bob10042/AGX-switching-box-remote-control/diagrams/AGX_Test_Box_Circuit.pdf

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

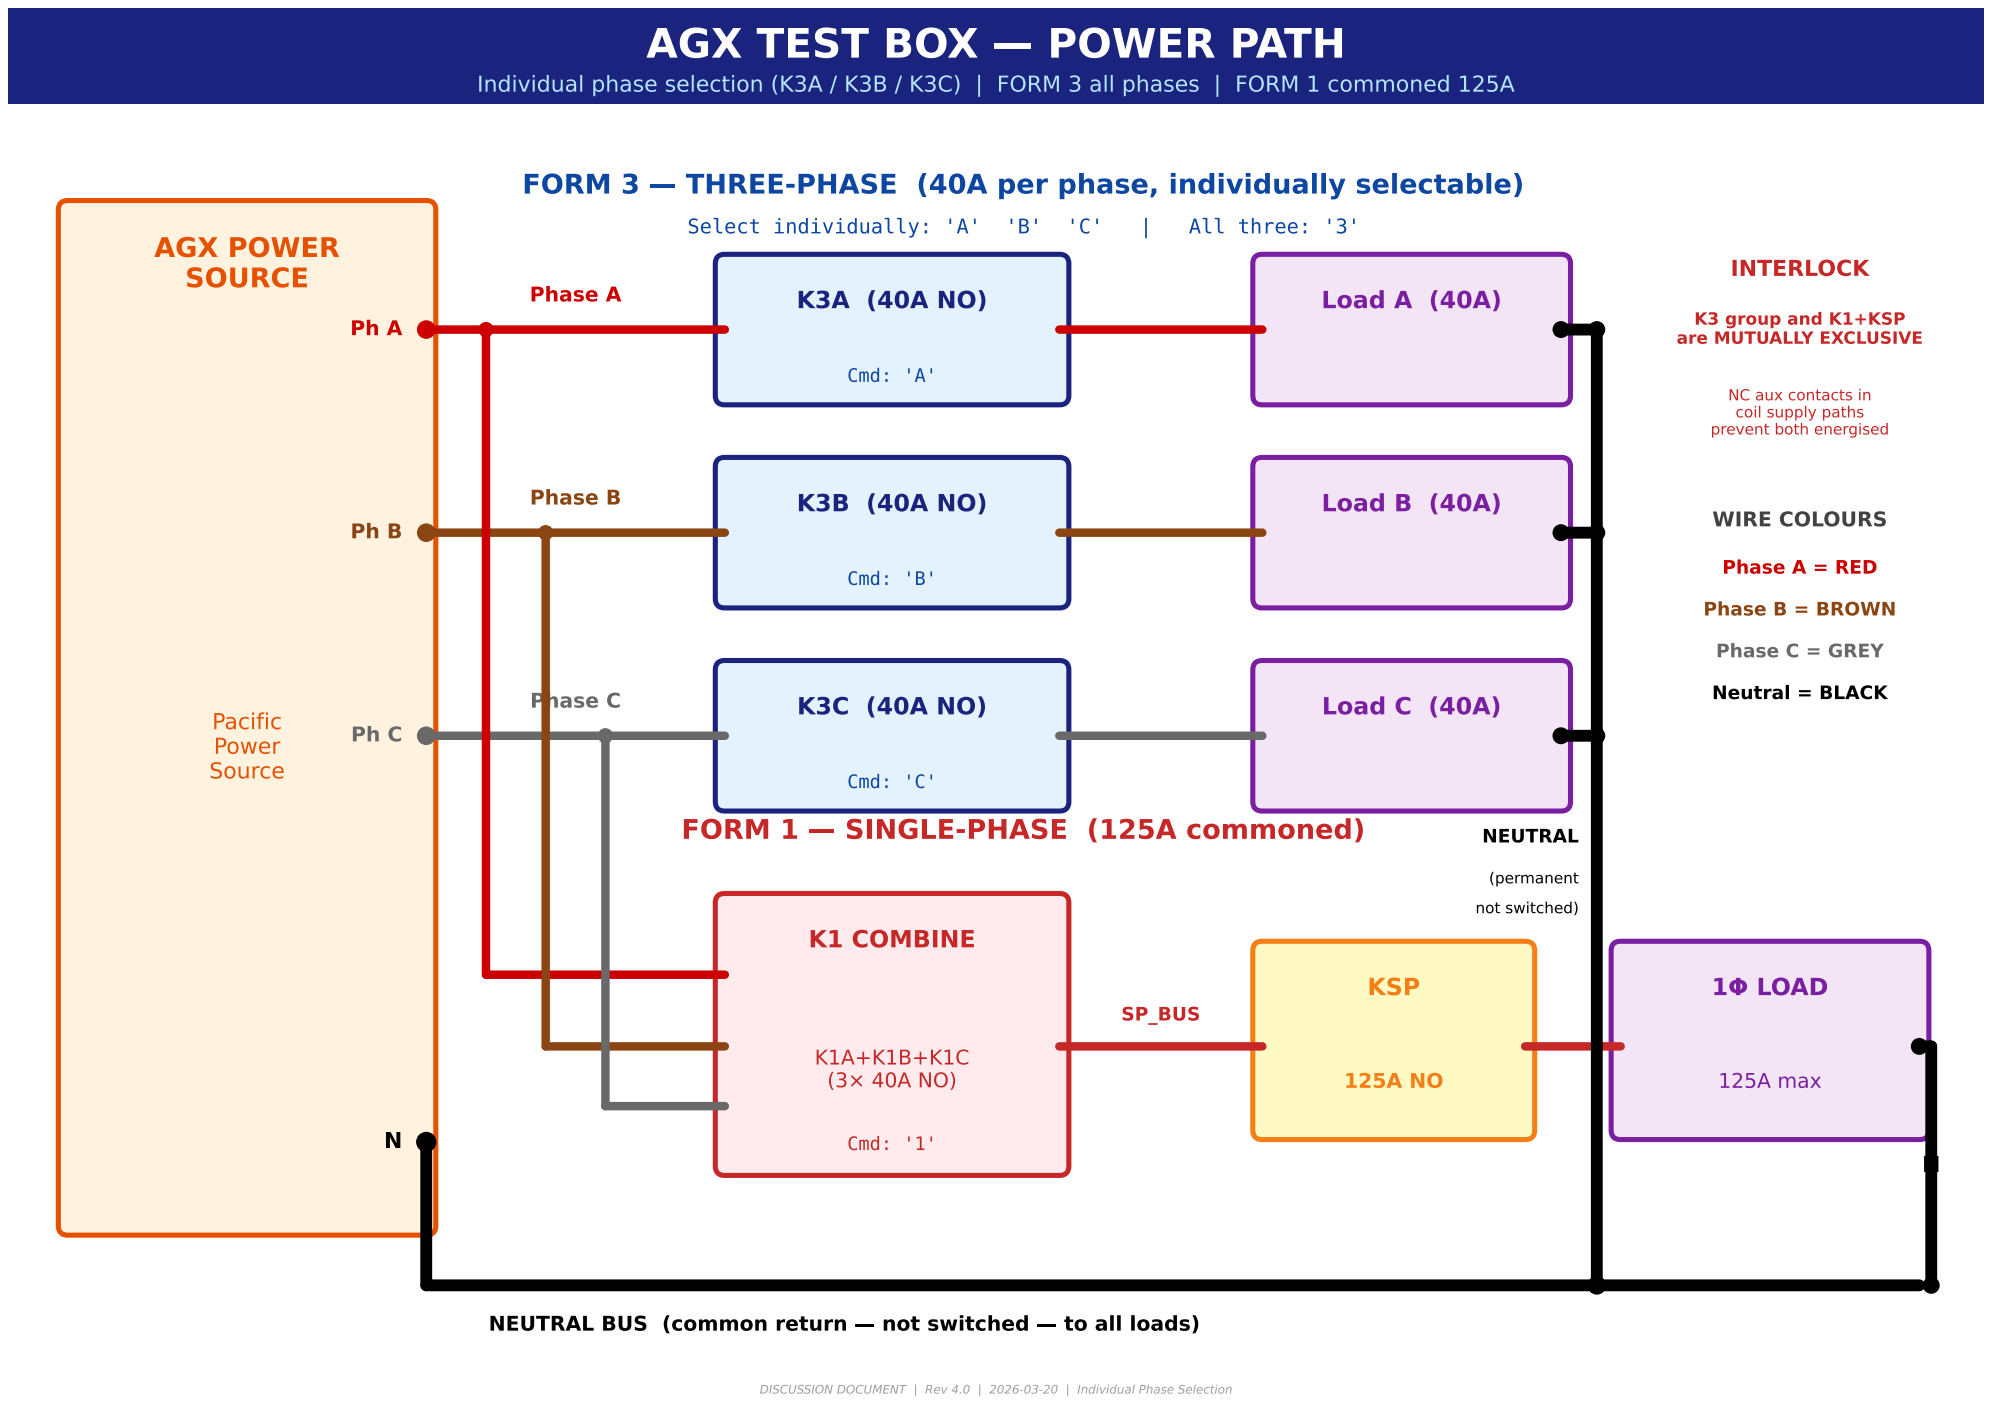
[picture p1: page 1]

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

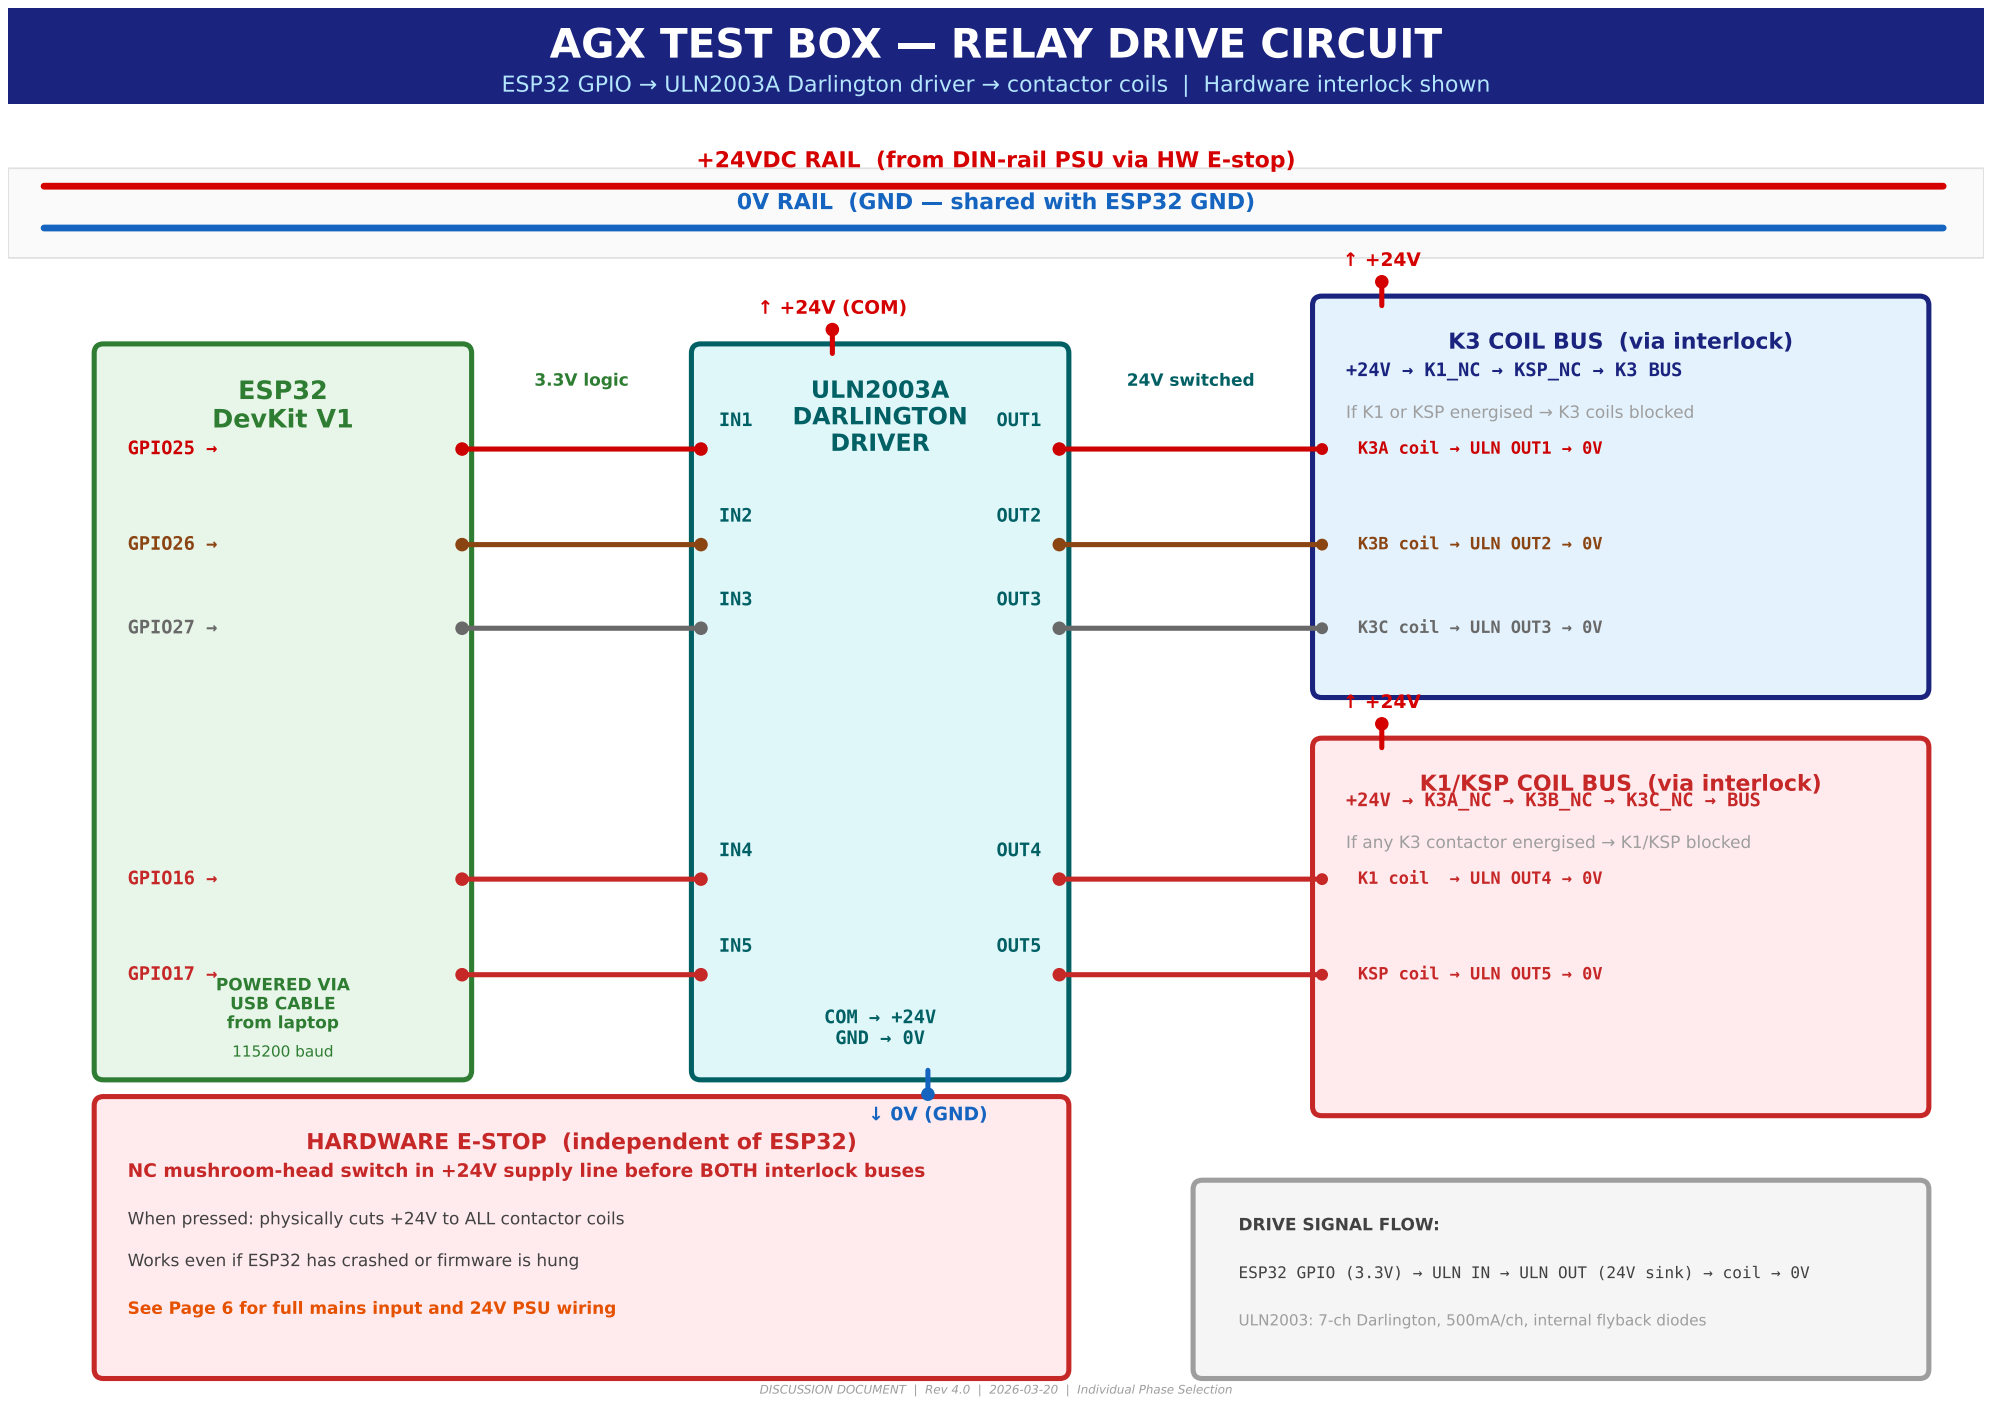
[picture p2: page 2]

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

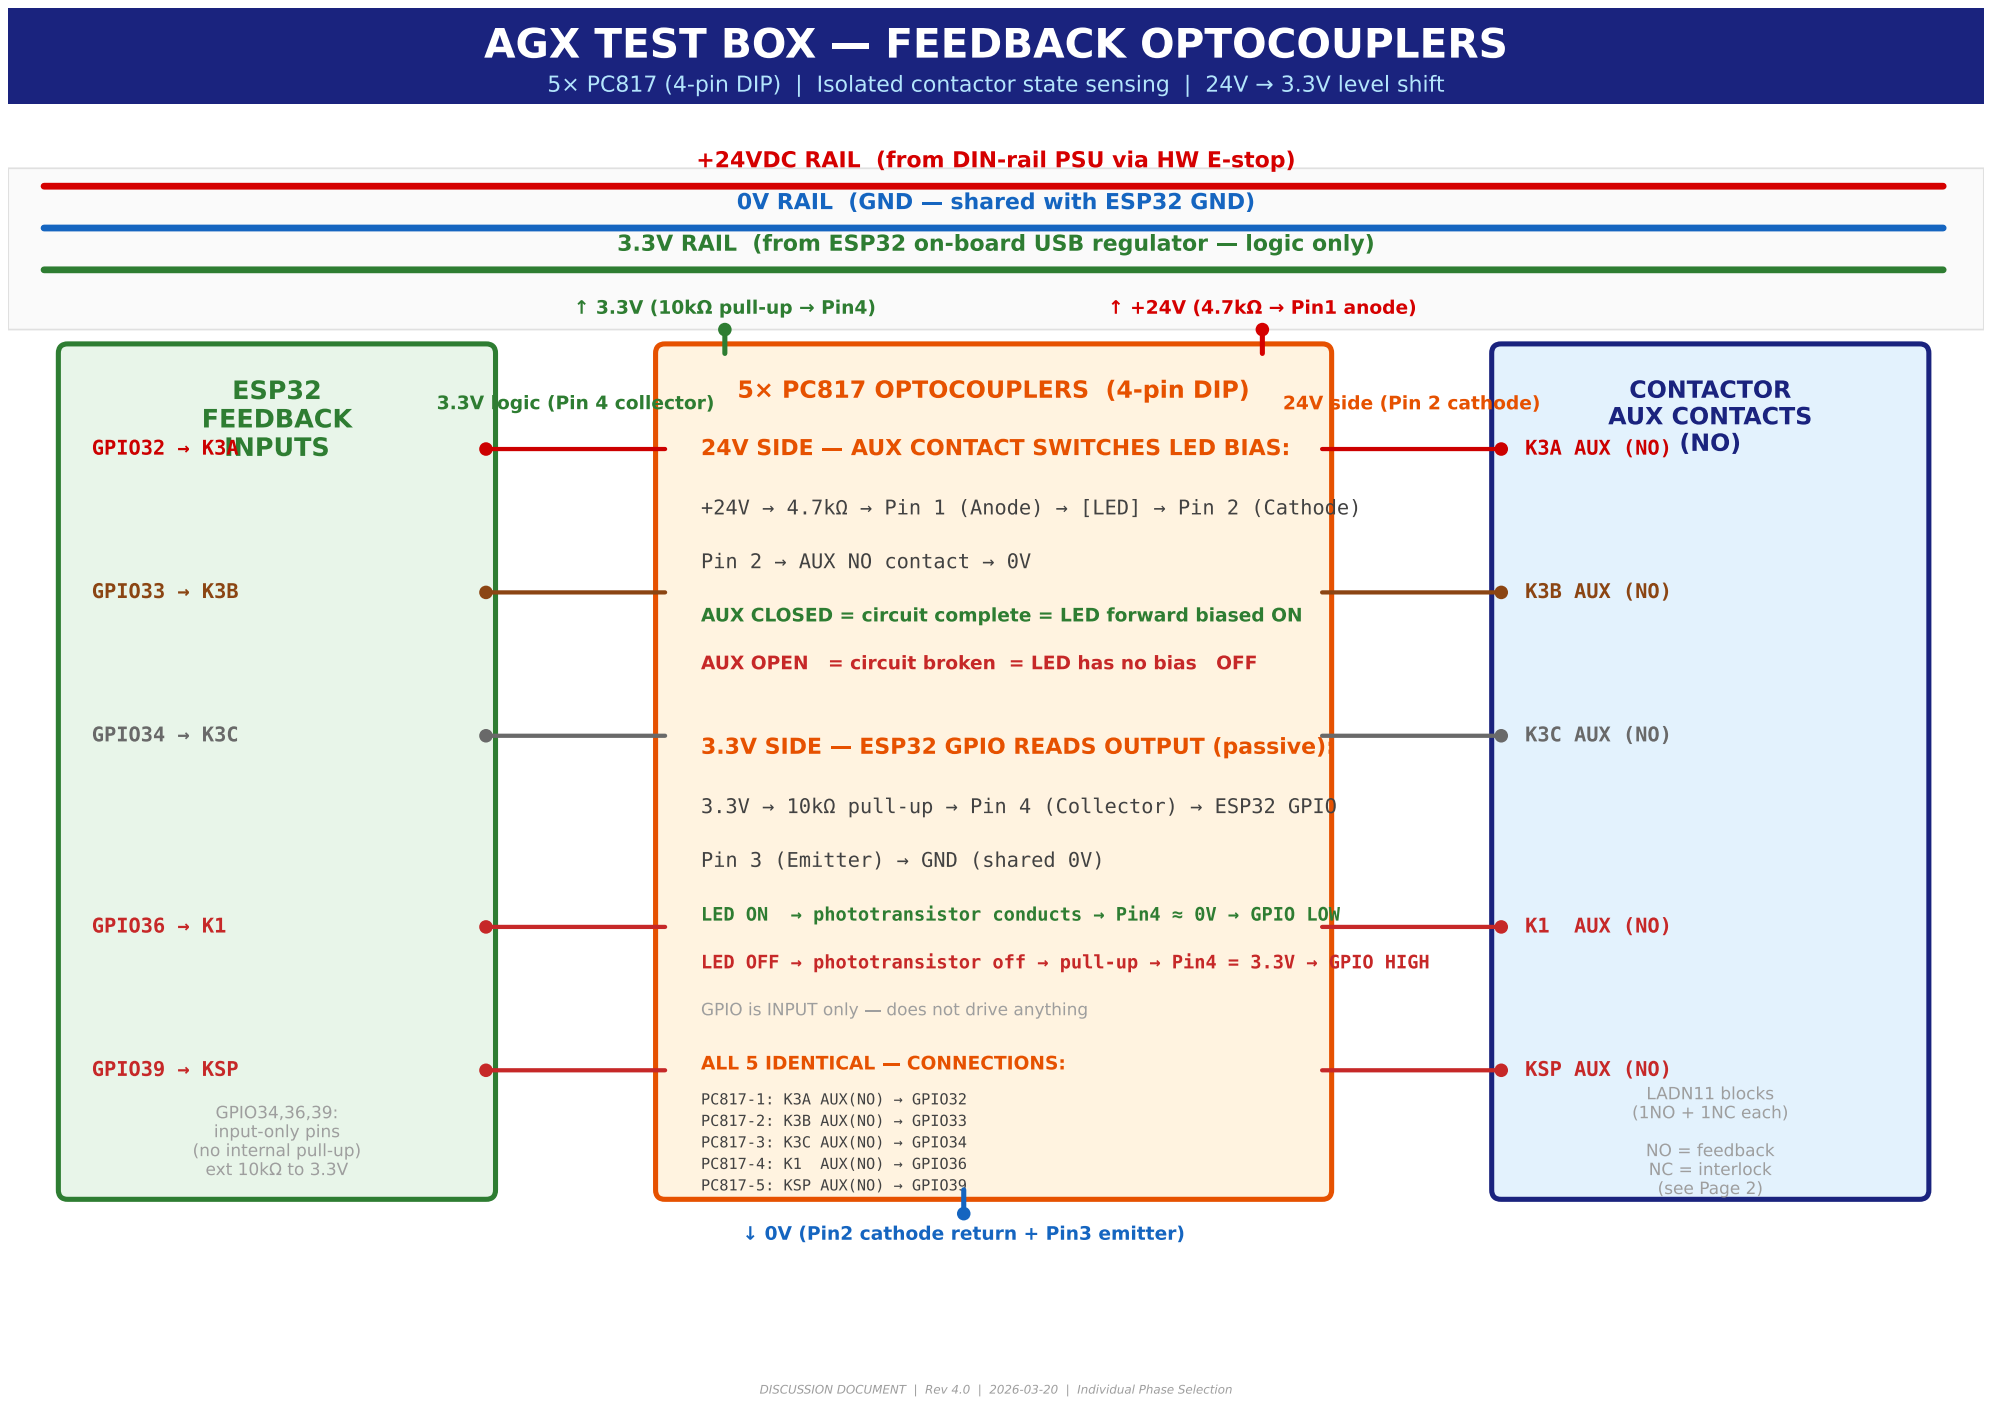
[picture p3: page 3]

# AGX TEST BOX STATUS LEDs & E-STOP

### 3× status LEDs with calculated resistors | Software + hardware E-stop

DISCUSSION DOCUMENT | Rev 4.0 | 2026-03-20 | Individual Phase Selection

## STATUS LEDs

LED CIRCUITS (ESP32 3.3V GPIO | resistor | LED | 0V / GND):

## GREEN LED:

GPIO18 | 330 | GREEN LED | 0V (GND)
Vf | 2.0V | I = (3.3V | 2.0V) / 330 | = 3.9mA

ON = any FORM3 phase active (K3A/K3B/K3C)

## BLUE LED:

GPIO19 | 100 | BLUE LED | 0V (GND)
Vf | 3.0V | I = (3.3V | 3.0V) / 100 | = 3.0mA

ON = FORM1 active (K1+KSP)

## RED LED:

GPIO21 | 330 | RED LED | 0V (GND)
Vf | 1.8V | I = (3.3V | 1.8V) / 330 | = 4.5mA
BLINK = fault | SOLID = E-stop

0V (GND LED cathode return)

## E-STOP (two independent systems)

## SOFTWARE E-STOP:

ESP32 GPIO35 | NO pushbutton | GND
External 10k | pull-up to 3.3V (GPIO35 is input-only)
Press button | GPIO reads LOW | firmware disables all outputs

Send '0' command to reset from ESTOP state

## HARDWARE E-STOP:

### NC mushroom-head pushbutton in +24V supply line

Positioned AFTER PSU, BEFORE both interlock buses

When pressed: physically cuts +24V to ALL contactor coils

Works even if ESP32 has crashed or firmware is hung

Twist to release, then send '0' to clear firmware state

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

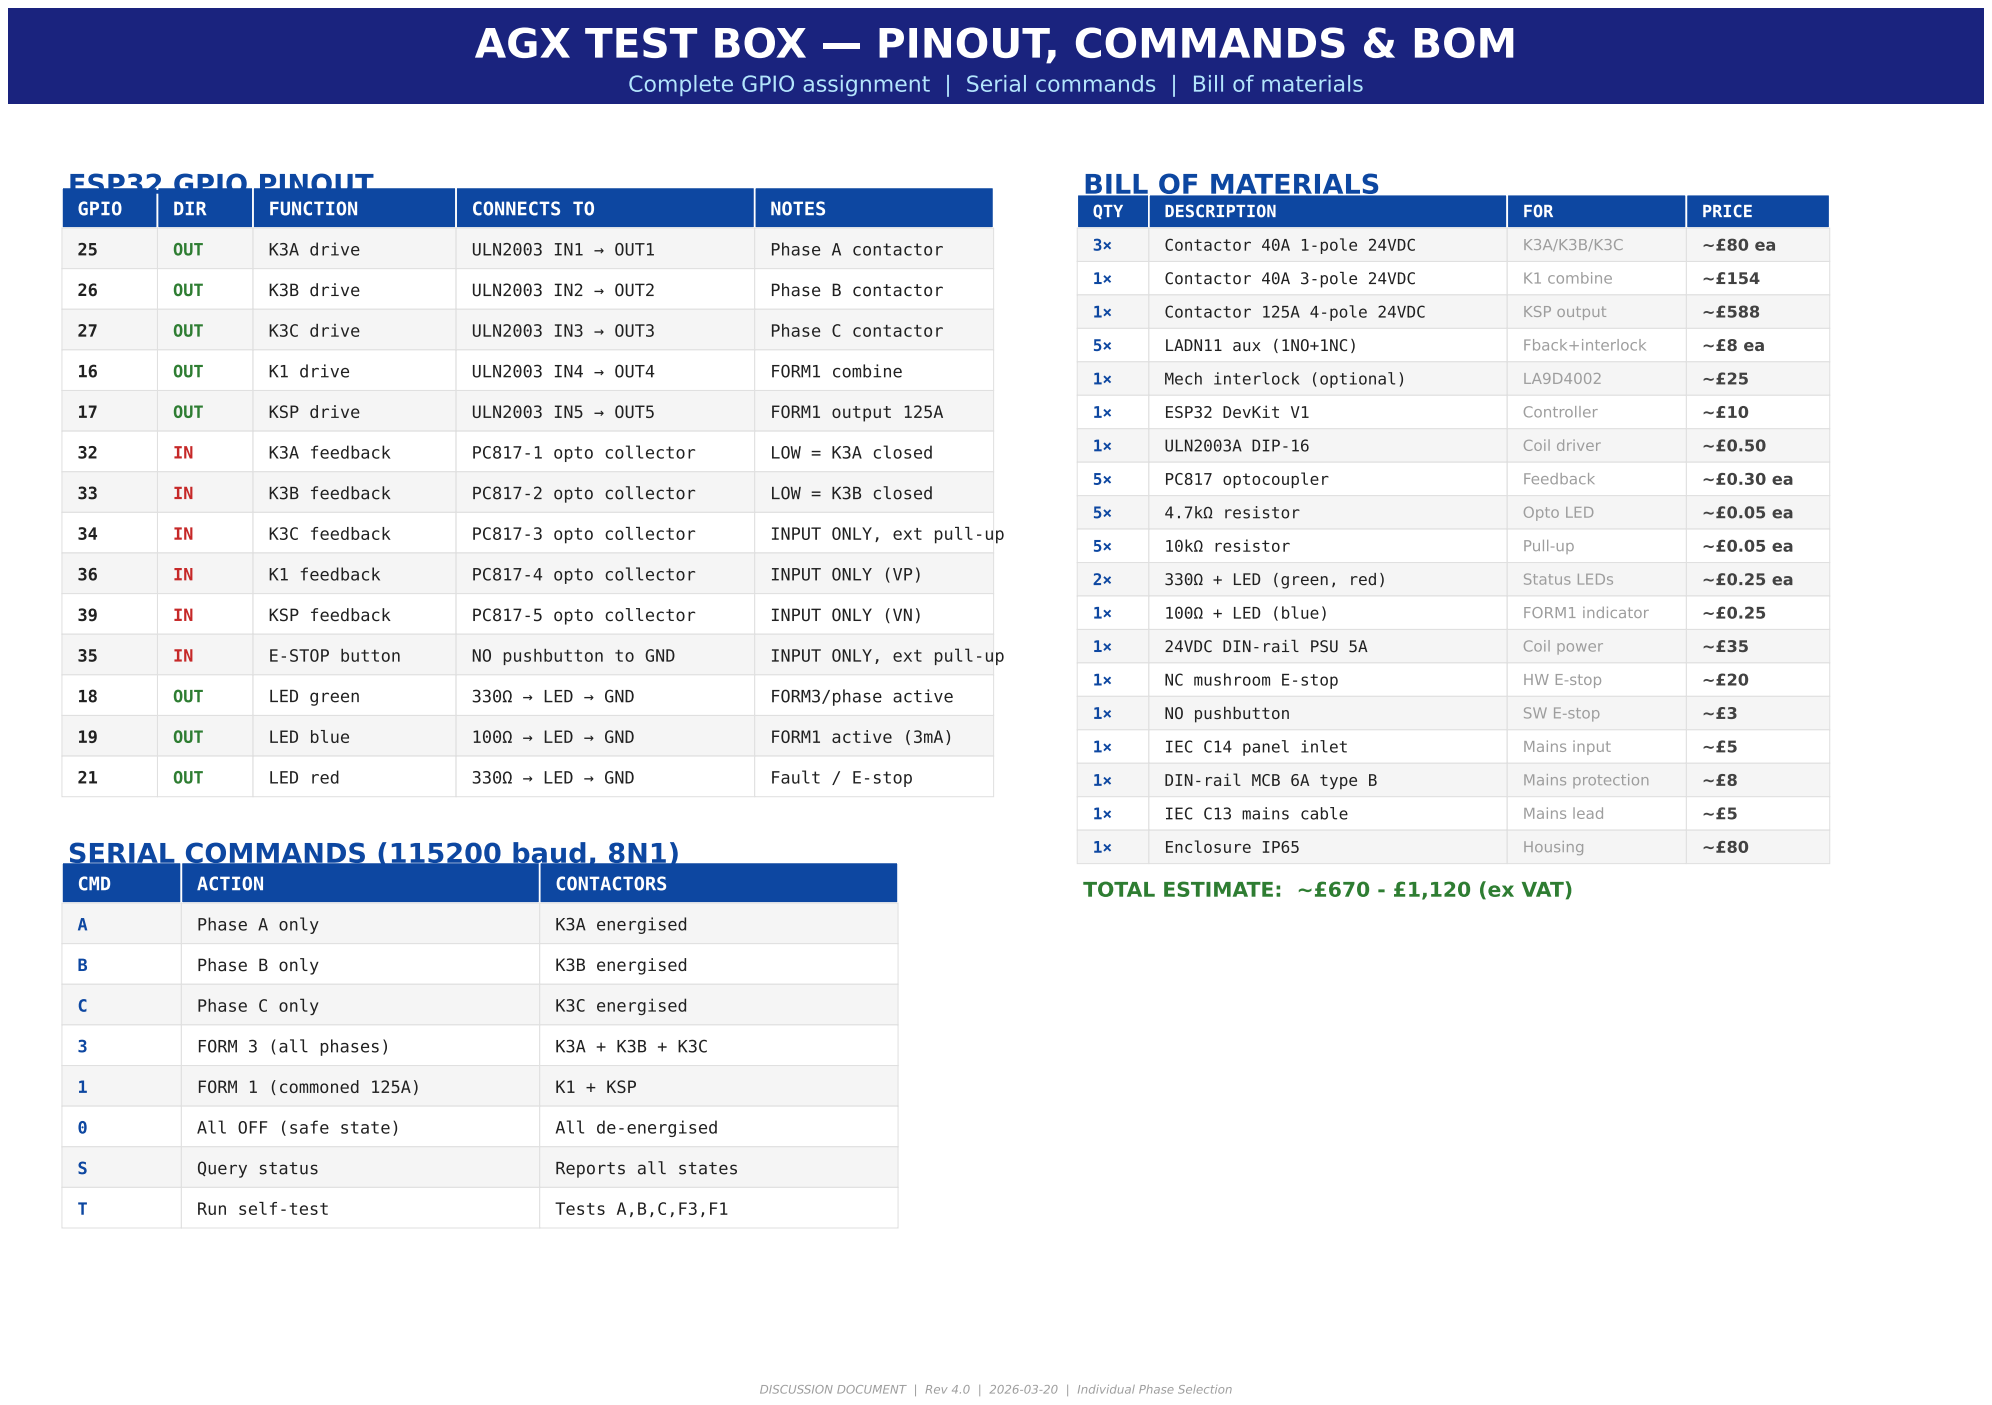
[picture p4: page 5]

# AGX TEST BOX MAINS INPUT & 24V POWER SUPPLY

### 230VAC mains input | DIN-rail PSU | Hardware E-stop | Earth bonding

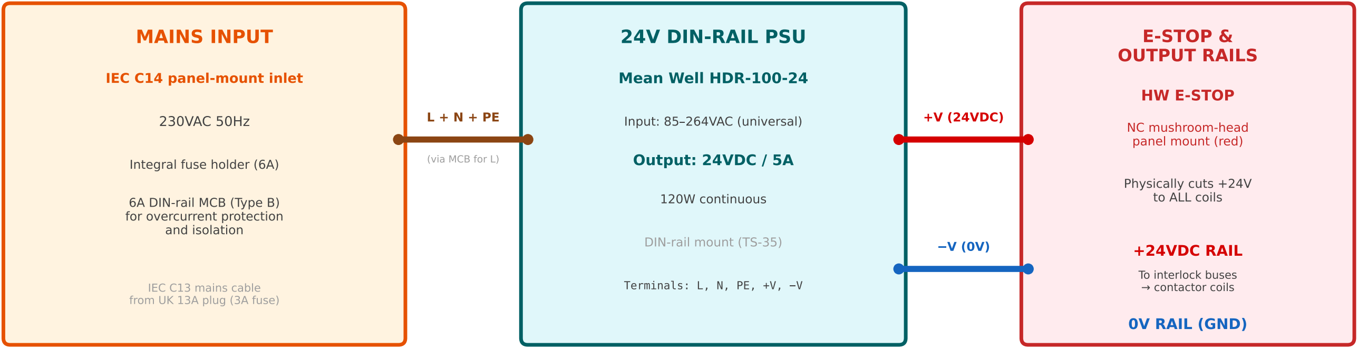
[picture p5: figure]
MAINS INPUT; IEC C14 panel-mount inlet; 230VAC 50Hz; Integral fuse holder (6A); 6A DIN-rail MCB (Type B) for overcurrent protection and isolation; IEC C13 mains cable from UK 13A plug (3A fuse); 24V DIN-RAIL PSU; Mean Well HDR-100-24; Input: 85 264VAC (universal); Output: 24VDC / 5A; 120W continuous; DIN-rail mount (TS-35); Terminals: L, N, PE, +V,; E-STOP & OUTPUT RAILS; HW E-STOP; NC mushroom-head panel mount (red); Physically cuts +24V to ALL coils; +24VDC RAIL; To interlock buses contactor coils; 0V RAIL (GND); (via MCB for L); +V (24VDC)

DISCUSSION DOCUMENT | Rev 4.0 | 2026-03-20 | Individual Phase Selection

## EARTH BONDING & SAFETY NOTES

## EARTH BONDING PATH:

IEC inlet E (green/yellow) | enclosure bonding stud | DIN rail | PSU PE terminal

All metal parts of enclosure must be bonded to protective earth

## SAFETY REQUIREMENTS:

All mains wiring must be performed by a competent person

Earth bonding to metal enclosure and DIN rail is mandatory

Keep mains wiring physically separated from low-voltage control wiring

IEC inlet fuse holder: fit 6A anti-surge fuse (keep spare in lid)

Test earth continuity before first power-on

Label enclosure: 'CAUTION 230VAC INSIDE'

## MAINS WIRE COLOURS (UK):

Live = BROWN

Neutral = BLUE

Earth = GREEN/YELLOW

## POWER CHAIN:

230VAC mains | IEC C14 inlet | 6A MCB | 24V PSU
HW E-STOP (NC) | +24VDC RAIL | interlock buses
0V from PSU | 0V RAIL (shared GND with ESP32)
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
