bob10042/AGX-switching-box-remote-control/(commit log)

2026-03-19 Initial commit: AGX Test Box switching controller
    ESP32-based remote control for switching between FORM 3 (three-phase 40A)
    and FORM 1 (single-phase 125A) on Pacific Power Source AGX/AFX units.
    Includes:
    - ESP32 Arduino firmware with break-before-make switching, feedback
    verification, hardware interlock support, and E-stop handling
    - 4-page PDF circuit block diagrams (phase colours, supply rails, BOM)
    - Python diagram generator script (matplotlib)
    - Detailed operation manual covering wiring, safety, commissioning
    - README with quick-start guide and full documentation references
2026-03-20 Rev 2.0: Individual phase selection, A3 diagrams, full docs update
    - Firmware: 5 independent contactor drives (K3A/K3B/K3C/K1/KSP),
    new commands A/B/C for individual phases, break-before-make
    switching with 5-channel feedback verification
    - Diagrams: Rewritten for A3 landscape with generous spacing,
    no lines through blocks, prominent supply rails, larger text
    - Docs: Operation manual and README updated for all 6 modes
    (Phase A/B/C, FORM 3, FORM 1, OFF), updated GPIO table,
    interlock wiring, BOM
2026-03-21 Add mains input, 24V PSU and earth bonding (Page 5)
    - New Page 5 diagram: 230VAC mains via IEC C14 inlet, 6A MCB,
    Mean Well 24V PSU, HW E-stop in +24V line, earth bonding
    and safety notes
    - Page 2: E-STOP block references Page 5 for full PSU wiring
    - BOM updated: IEC C14 inlet, DIN-rail MCB 6A, mains cable
    - Operation Manual: new mains wiring section with wire colours,
    PSU chain diagram, and safety notes
    - README: updated for 5-page diagram set and BOM additions
2026-03-21 Fix Page 5: clean block layout, no lines through blocks
    - Redesigned Page 5 with three blocks in a row (Mains Input,
    PSU, E-STOP & Output Rails) with 1.5-unit gaps between them
    - All wires routed through gaps only, no crossing through blocks
    - No blocks squashed against each other
    - Earth bonding & safety notes in full-width block at bottom
    - Page 2 E-STOP block references Page 5 for PSU details
    [agx_circuit_pdf.py]
2026-03-21 Update all docs for mains input, complete BOM, commissioning
    README:
    - Added mains input description (IEC C14, MCB, PSU chain)
    - Added mains wire colours table (UK: brown/blue/green-yellow)
    - Completed BOM with resistors, LEDs, E-stop, enclosure
    - Updated supply rails description to show full power chain
    - Fixed diagram reference to 5-page A3
    Operation Manual:
    - Added mains specs to specifications summary table
    - Added mains wire colours to specs
    - Updated commissioning: earth continuity test, mains connection,
    HW E-stop test (mushroom-head) as separate step from SW E-stop
2026-03-21 Complete circuits: neutral returns, bigger text, LED GND
    Page 1 (Power Path):
    - Added thick neutral return bus connecting ALL loads back to
    neutral bus (FORM 3 loads via vertical return, 1Φ load separate)
    - Loads now show complete circuit: phase in + neutral return
    - Increased text sizes throughout (labels 11-12pt, titles 14-15pt)
    Page 2 (Relay Drives):
    - Increased GPIO, channel, and interlock text sizes
    - E-STOP references Page 5 for PSU details
    Page 3 (Feedback):
    - Added 0V rail connection stub on LED block (shows GND path)
    - Increased aux contact, opto, and feedback pin text sizes
    All pages: text inside blocks now 1-2pt larger for readability
    README & Operation Manual:
    - Complete B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
2026-03-21 Fix blue LED resistor: 330Ω → 100Ω (Vf≈3.0V needs lower R)
    Blue LED at 3.3V with 330Ω only gets 0.9mA (barely visible).
    Changed to 100Ω giving ~3mA with high-efficiency blue LED.
    - Green: 330Ω → 3.9mA (Vf≈2.0V) ✓
    - Blue: 100Ω → 3.0mA (Vf≈3.0V) ✓ (was 330Ω/0.9mA)
    - Red: 330Ω → 4.5mA (Vf≈1.8V) ✓
    Updated in: diagrams (Page 3 LEDs, Page 4 GPIO table, BOM),
    Operation Manual (GPIO table, wiring section with Vf/I calcs),
    README (GPIO table, BOM)
    [agx_circuit_pdf.py]
2026-03-21 Add detailed connection schedule (101 wires, point-to-point)
    New docs/CONNECTION_SCHEDULE.md with:
    - Every wire numbered W1-W101, From/To/Colour/Cable size
    - 12 sections: mains, 24V supply, ESP32→ULN, K3 coil bus,
    K1/KSP coil bus, feedback optos (24V+3.3V sides),
    SW E-stop, LEDs, phase wiring (FORM 3+1), neutral
    - Resistor schedule (R1-R14) with calculated currents
    - LADN11 aux contact block assignments (NO for feedback,
    NC for interlock, per contactor)
    - ULN2003A DIP-16 complete pin table
    - PC817 pin assignments
    - Wire count summary by section and cable size
2026-03-21 Split feedback/LEDs into separate pages (now 6 pages)
    Page 3: Feedback optocouplers only - full A3 page with:
    - PC817 4-pin DIP pin-by-pin connections (Pin 1-4)
    - 24V side and 3.3V side clearly labelled
    - Output logic (AUX closed/open → GPIO LOW/HIGH)
    - Per-opto connection table (5× PC817 to AUX and GPIO)
    - ESP32 on left, optos centre, AUX contacts right
    Page 4: Status LEDs & E-stop (new page) with:
    - Each LED circuit: GPIO → resistor → LED → 0V
    - Calculated values: Vf, I = (3.3-Vf)/R for each
    - Green (330Ω/3.9mA), Blue (100Ω/3.0mA), Red (330Ω/4.5mA)
    - SW E-stop (GPIO35) and HW E-stop (NC mushroom-head)
    Pages 5-6 renumbered (was 4-5)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
2026-03-21 Clarify opto circuit: AUX switches LED bias, GPIO reads output
    Page 3: Opto block now clearly shows:
    - 24V SIDE: AUX contact switches LED forward bias (ON/OFF)
    - 3.3V SIDE: ESP32 GPIO passively reads phototransistor output
    - GPIO is INPUT only, does not drive anything
    - Connection table fits inside block (was spilling below)
    Connection Schedule: Updated sections 6, 7, and PC817 pin table
    to explain bias switching and passive GPIO reading
    README: Updated for 6-page diagram set
2026-03-21 Fix: neutral labelled permanent/not switched, Page 6 reference
    - Page 1: Neutral return bus now labelled "NEUTRAL (permanent,
    not switched)" - makes clear it's always hard-wired to all
    loads, not going through any contactor
    - Page 2: Fixed E-STOP reference from "Page 5" to "Page 6"
    [agx_circuit_pdf.py]
2026-03-29 Fix page 3 optocoupler spacing: increase vertical gap to 1.7 units
    All 5 PC817 circuits now render without overlap. Also adds full
    schemdraw symbol upgrade: switch contacts, IC boxes, inductor coils,
    LED/resistor symbols, optocoupler symbols, fuse/breaker/PSU symbols
    across pages 1-4 and 6 (page 5 tables unchanged).
    [agx_circuit_pdf.py]
